peterdsharpe/phone-case/out/renders/camera_closeup.jpg

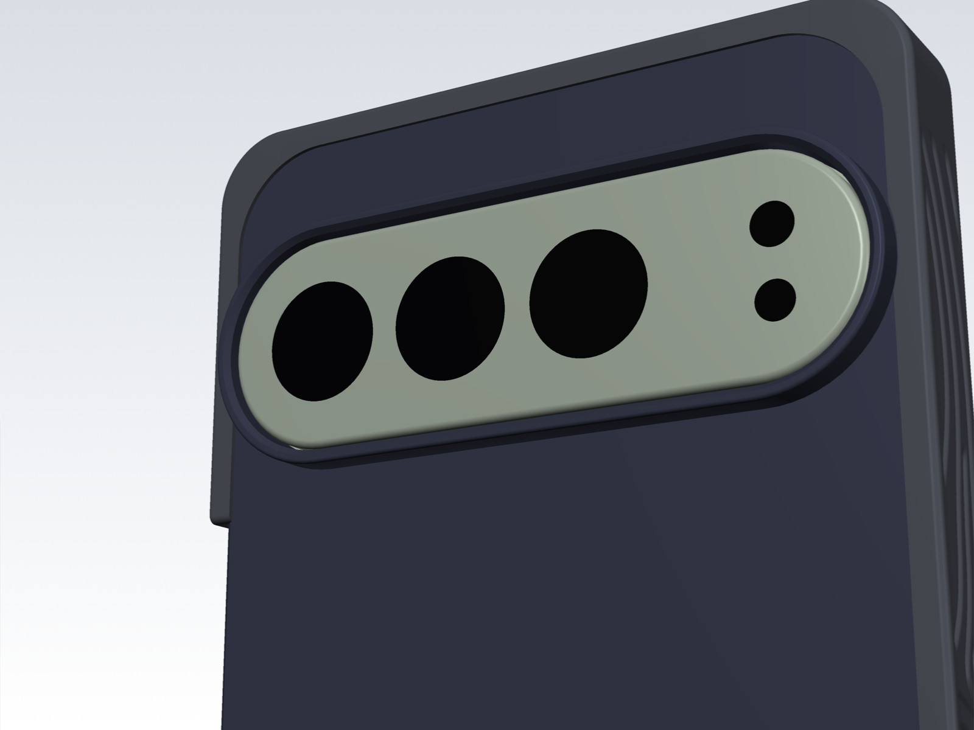
out/renders/camera_closeup.jpg
