peterdsharpe/phone-case/out/renders/corner_closeup.jpg

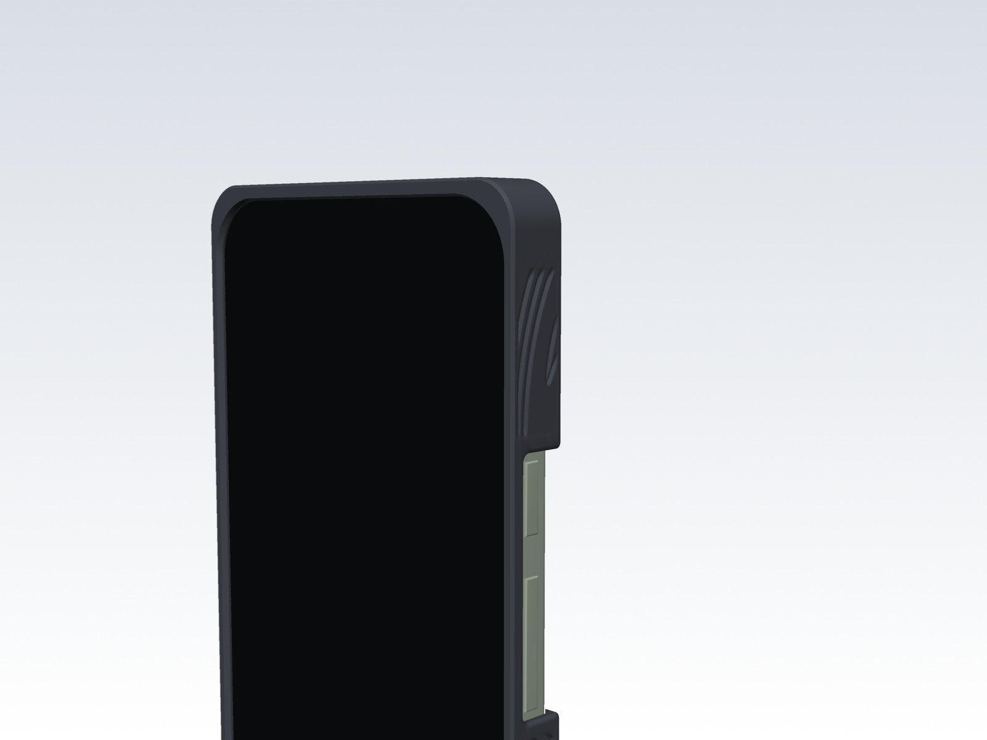
out/renders/corner_closeup.jpg
