peterdsharpe/phone-case/out/renders/exploded.jpg

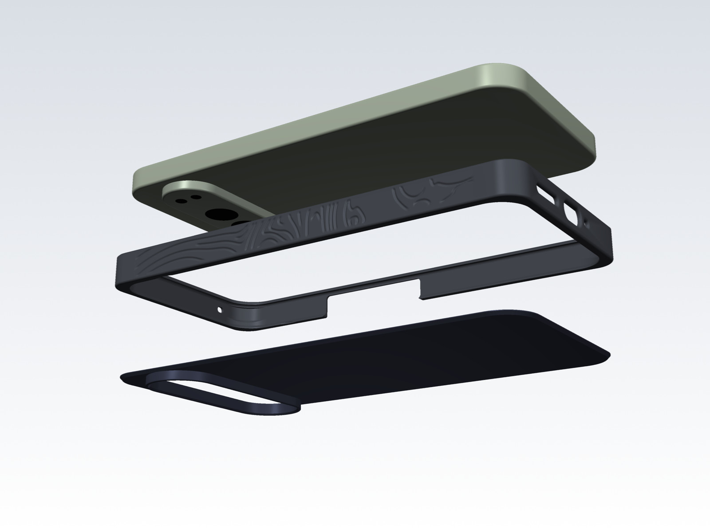
out/renders/exploded.jpg
