peterdsharpe/phone-case/out/renders/flow_spectra.png

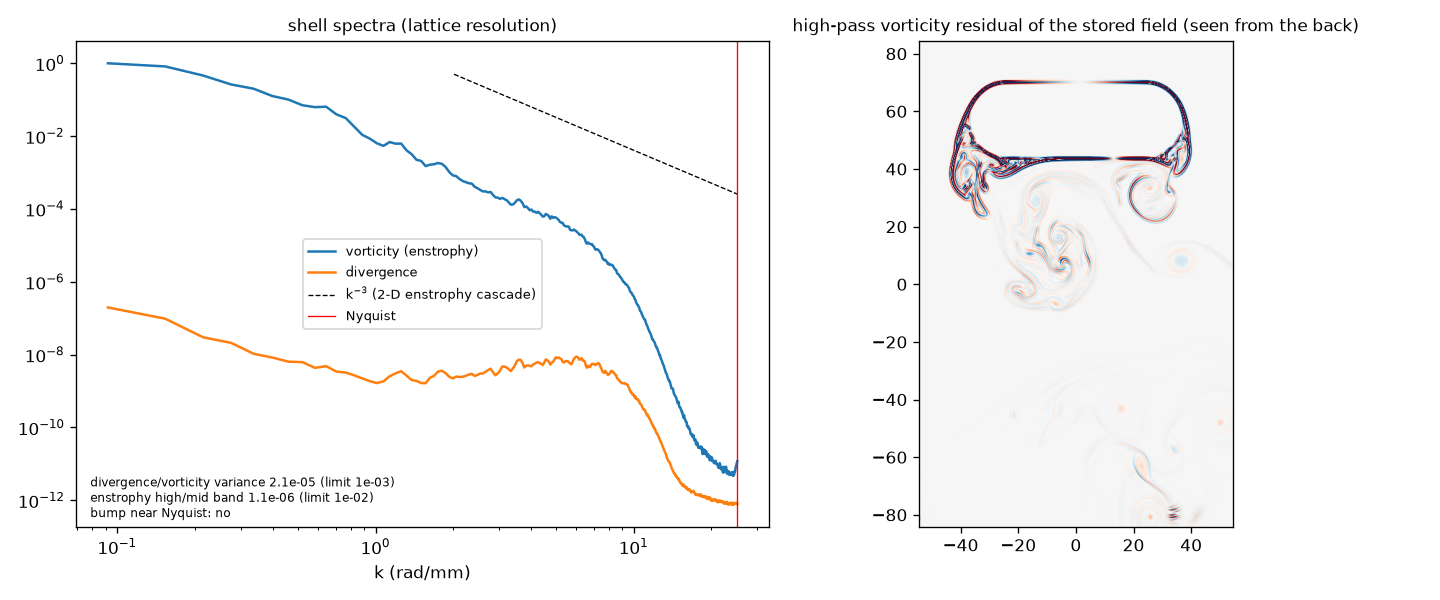
out/renders/flow_spectra.png
