peterdsharpe/phone-case/out/renders/sections.png

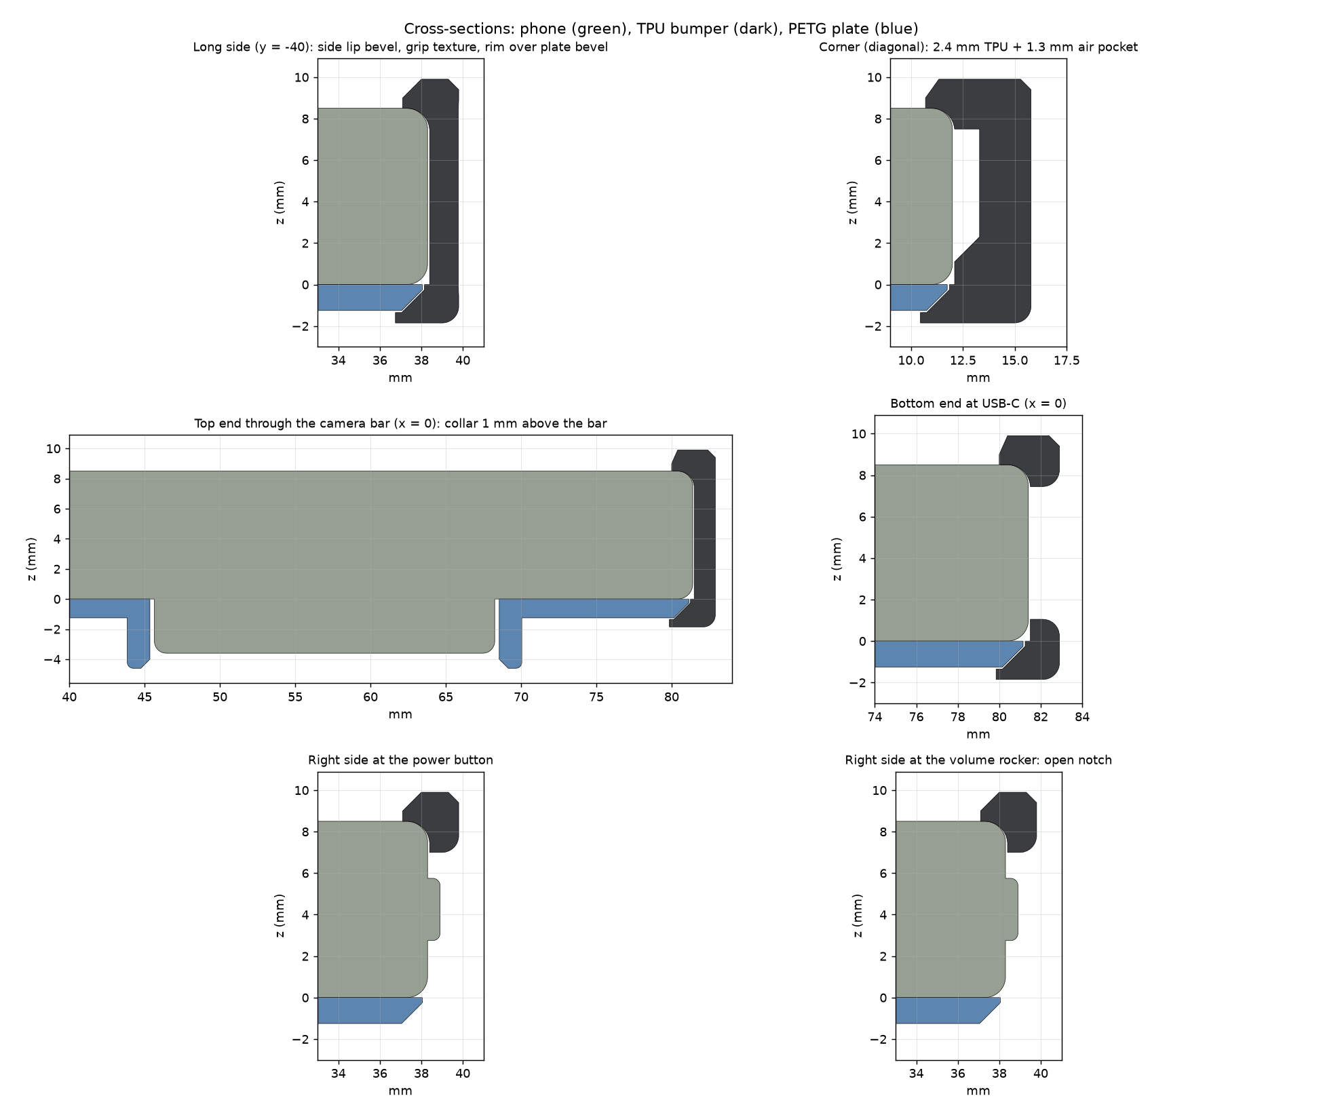
out/renders/sections.png
