peterdsharpe/phone-case/out/renders/stream_bead_detail.jpg

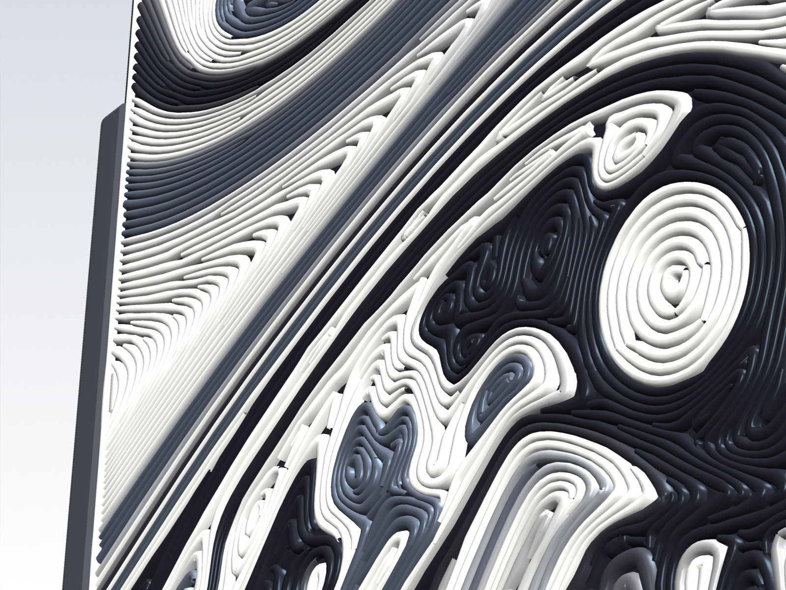
out/renders/stream_bead_detail.jpg
