peterdsharpe/phone-case/out/renders/stream_collar_closeup.jpg

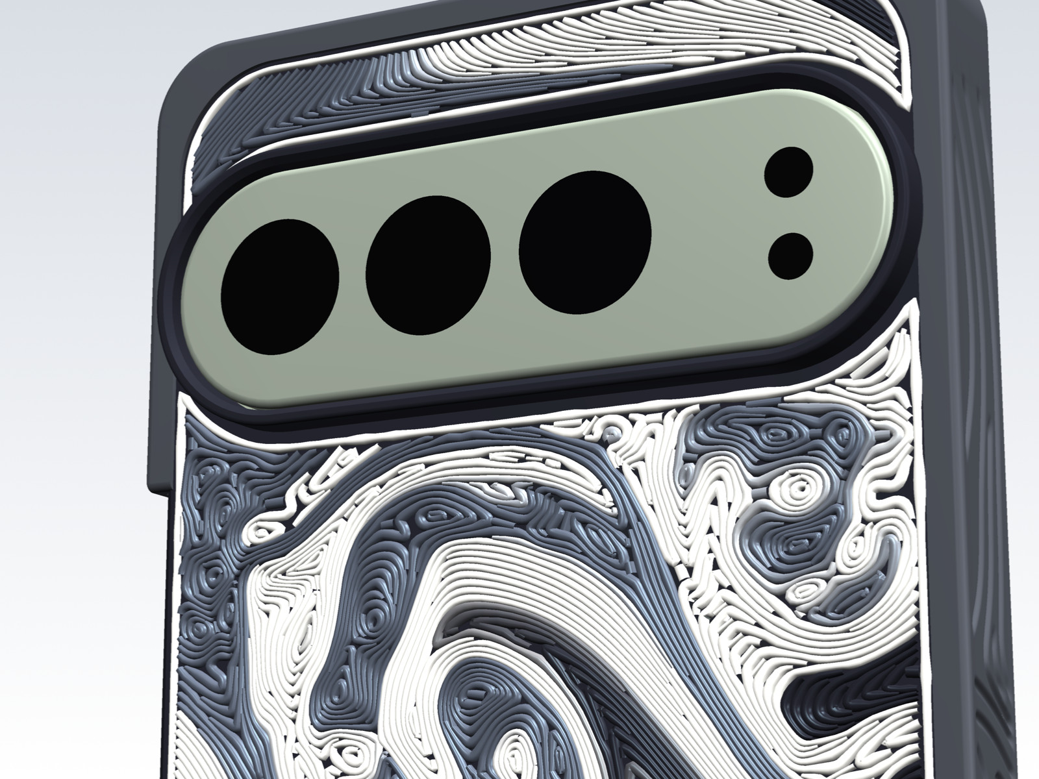
out/renders/stream_collar_closeup.jpg
