peterdsharpe/phone-case/out/renders/stream_plan_petg.jpg

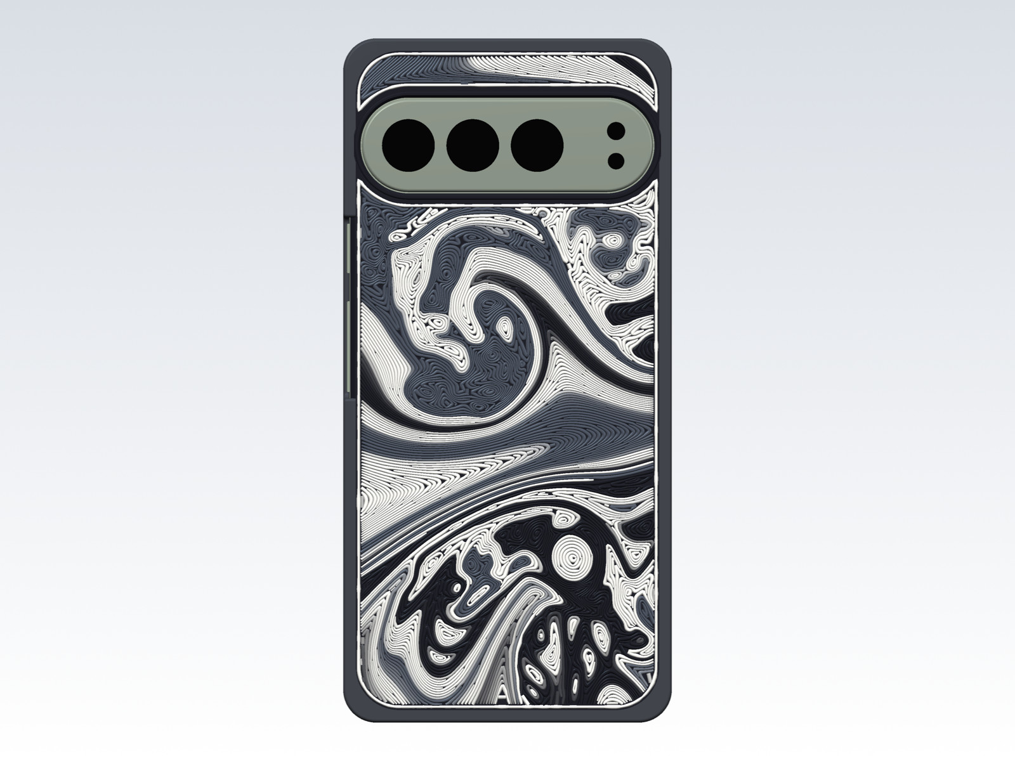
out/renders/stream_plan_petg.jpg
