peterdsharpe/phone-case/out/renders/streamline_flow.png

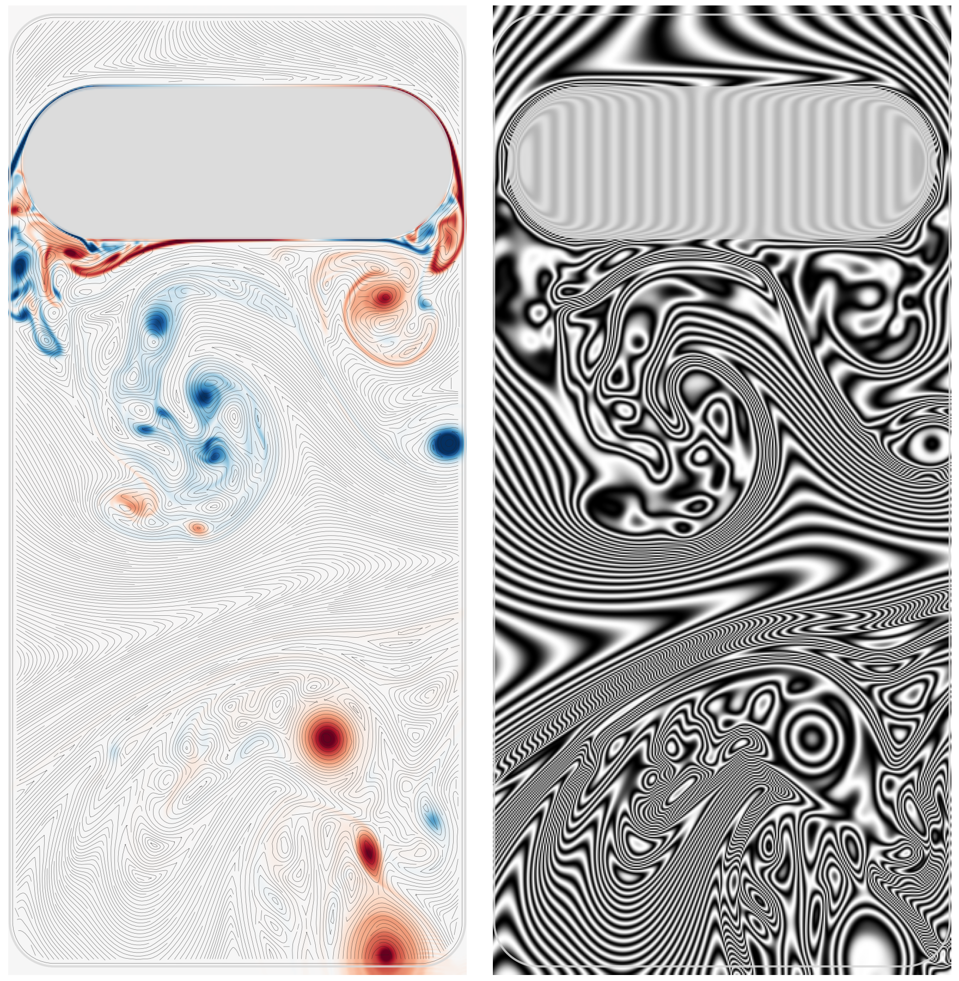
out/renders/streamline_flow.png
