peterdsharpe/phone-case/out/renders/streamline_toolpaths.png

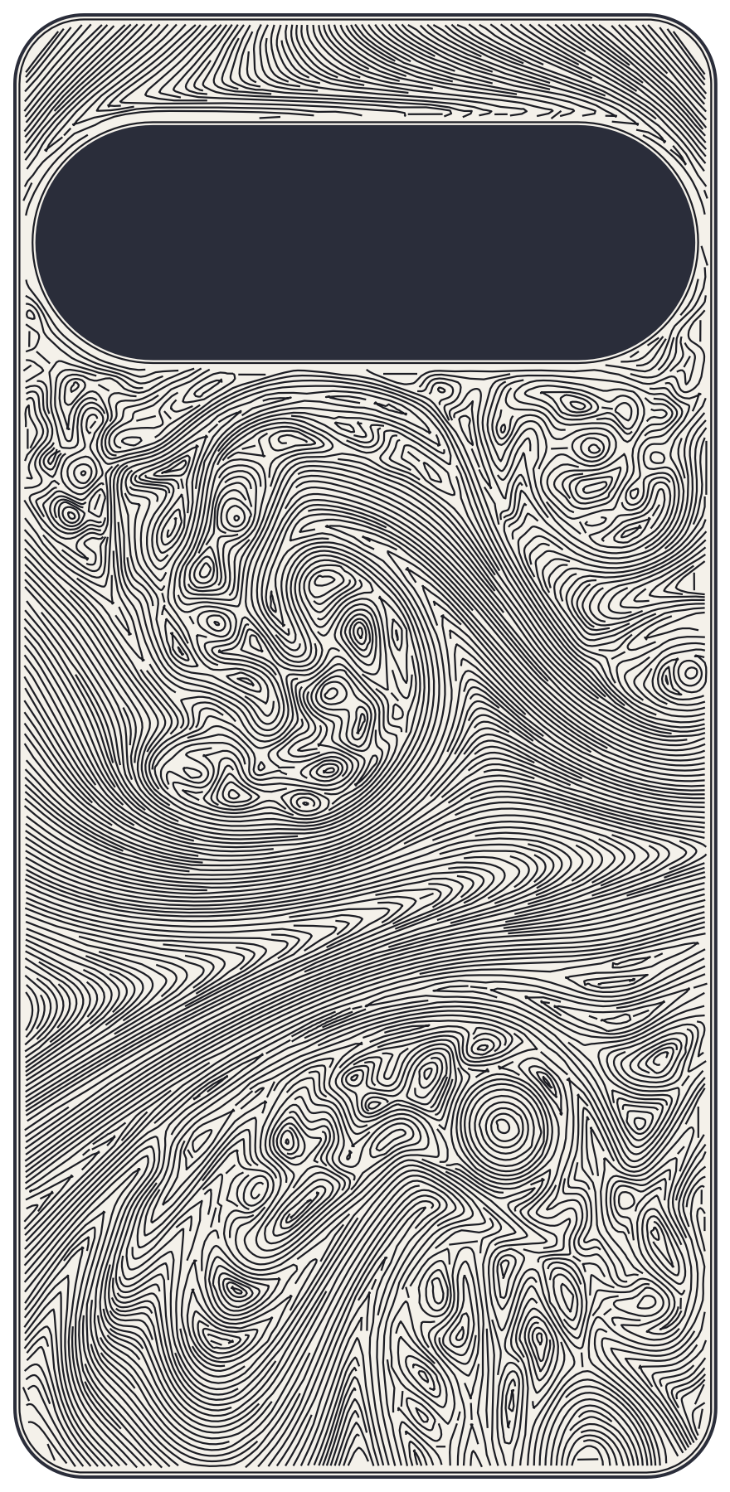
out/renders/streamline_toolpaths.png
