peterdsharpe/phone-case/out/print/case_back_petg.stl

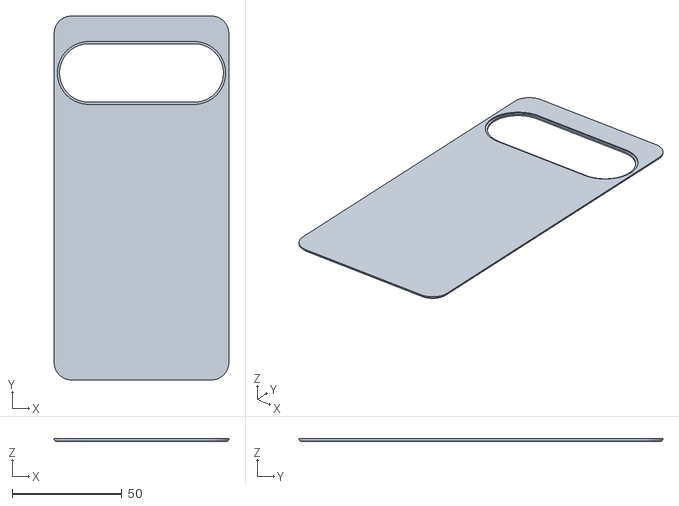
[picture p41: CAD file, 2026-10-22]
out/print/case_back_petg.stl
79.6 x 165.8 x 1.17
