peterdsharpe/phone-case/out/print/camera_ring.stl

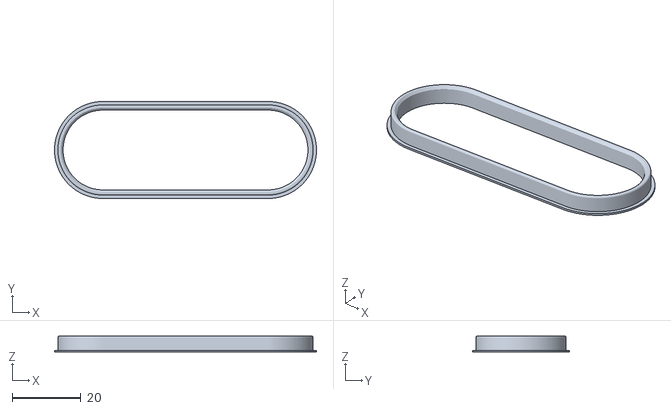
[picture p42: CAD file, 2026-10-22]
out/print/camera_ring.stl
76.2 x 28.2 x 4.60
