peterdsharpe/phone-case/out/print/case_fused.3mf

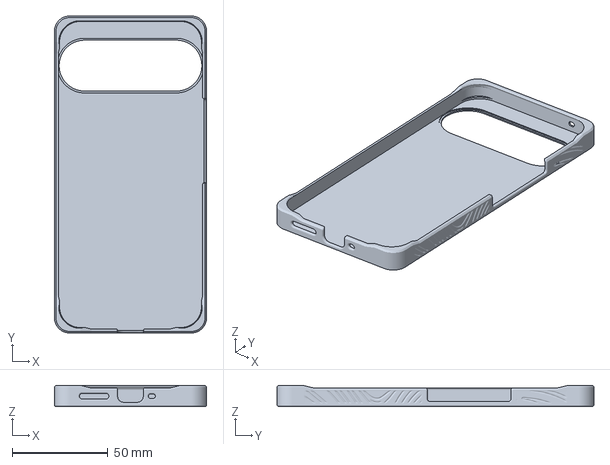
[picture p43: CAD file, 2026-10-22]
out/print/case_fused.3mf
79.6 x 165.8 x 11.1 mm
