peterdsharpe/phone-case/out/print/plate_pla.3mf

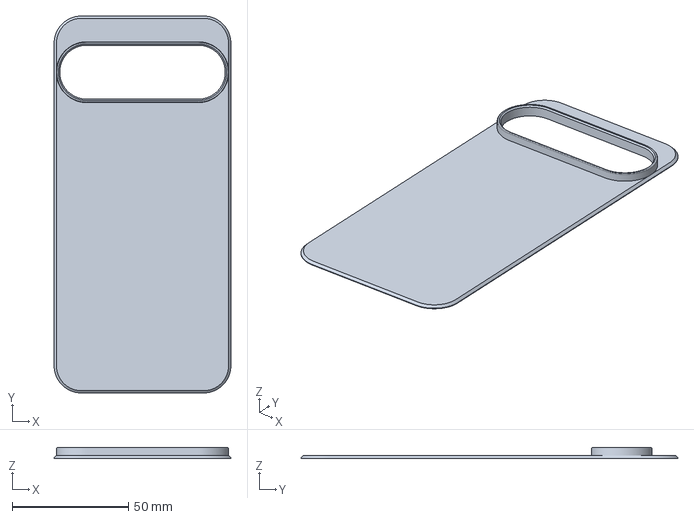
[picture p44: CAD file, 2026-10-22]
out/print/plate_pla.3mf
76.1 x 162.3 x 4.60 mm
