peterdsharpe/phone-case/out/print/test_camera_petg.3mf

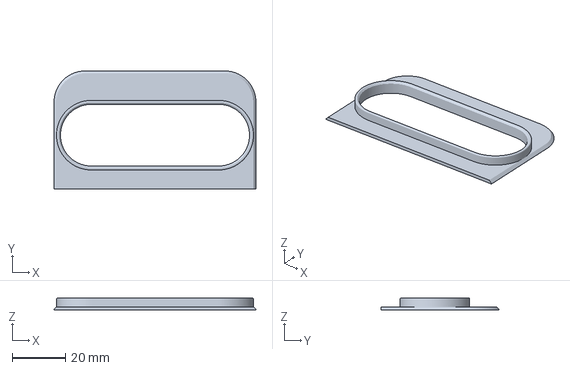
[picture p45: CAD file, 2026-10-22]
out/print/test_camera_petg.3mf
76.1 x 44.5 x 4.60 mm
