peterdsharpe/phone-case/out/print/test_fit_band_tpu.3mf

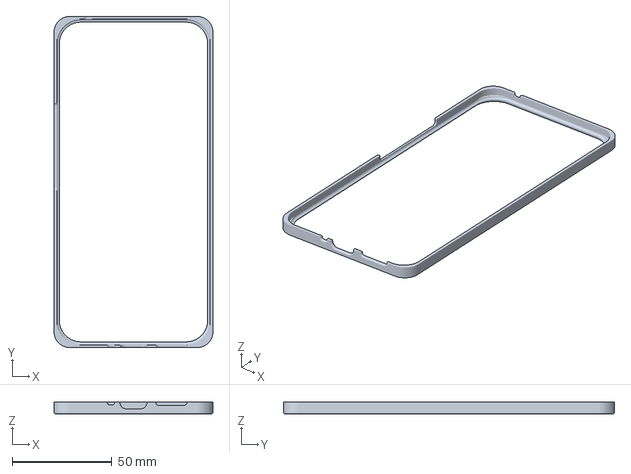
[picture p46: CAD file, 2026-10-22]
out/print/test_fit_band_tpu.3mf
79.6 x 165.8 x 5.90 mm
