peterdsharpe/phone-case/out/print/bumper_tpu.3mf

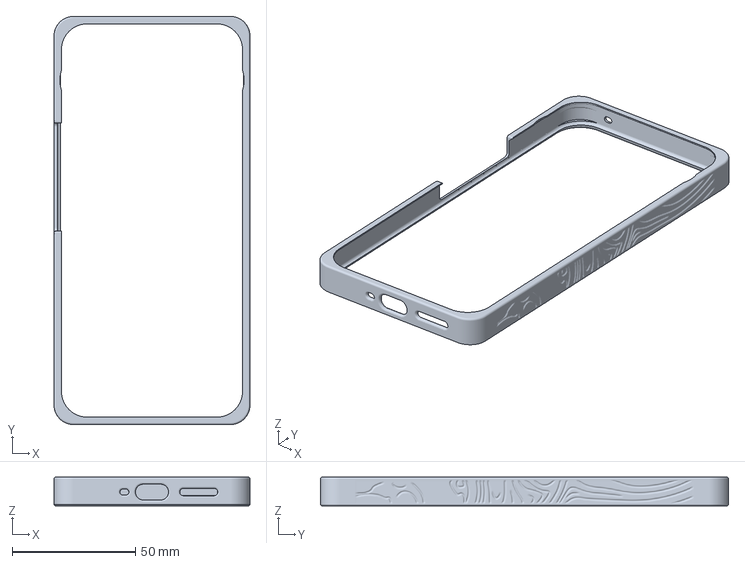
[picture p47: CAD file, 2026-10-22]
out/print/bumper_tpu.3mf
79.6 x 165.8 x 11.7 mm
