peterdsharpe/phone-case/out/print/bumper_petg.3mf

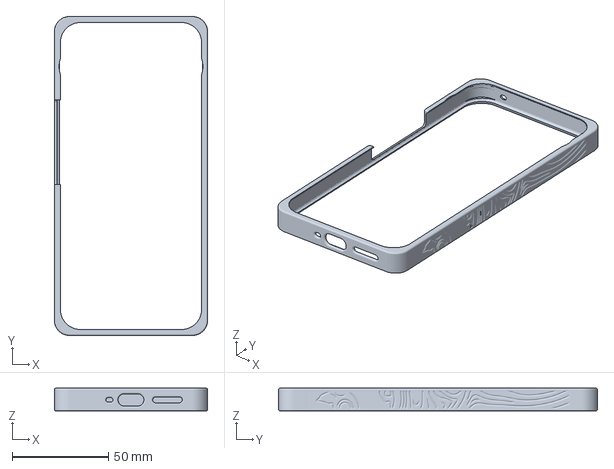
[picture p48: CAD file, 2026-10-22]
out/print/bumper_petg.3mf
79.8 x 166.0 x 11.7 mm
