peterdsharpe/phone-case/(list of files, cad)

Other CAD files:
out/print/camera_ring_petg.3mf
out/print/plate_petg.3mf
out/print/test_fit_band.stl
out/print/test_camera.stl
out/print/plate.stl
