peterdsharpe/phone-case/out/renders/print_layout.jpg

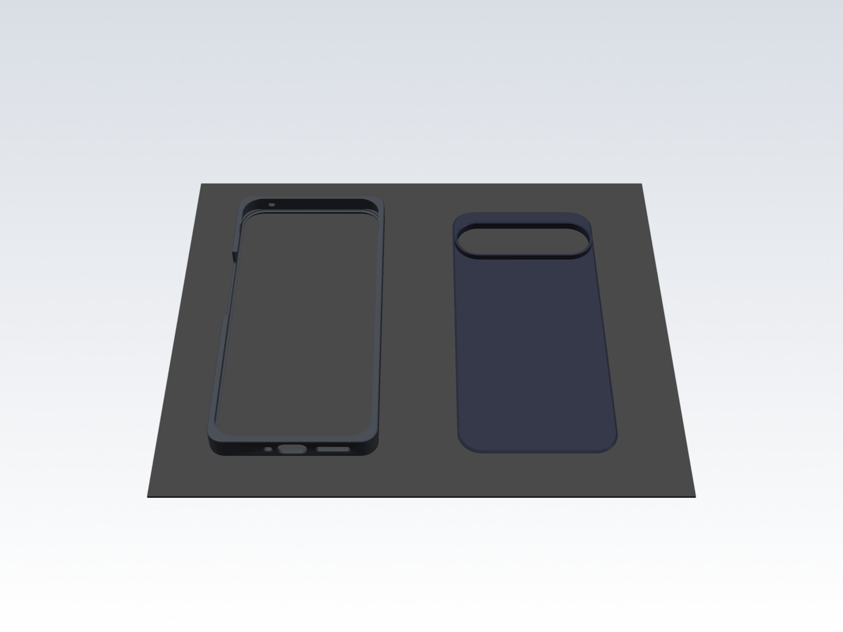
out/renders/print_layout.jpg
