peterdsharpe/phone-case/out/profiles/camera_ring_petg.ini

# PrusaSlicer config for camera_ring_petg: Original Prusa i3 MK3S & MK3S+ 0.6 nozzle + 0.15mm DETAIL @0.6 nozzle MK3 + Prusament PETG @0.6 nozzle + overrides.
# Import with File > Import > Import Config.
avoid_crossing_perimeters = 1
bed_shape = 0x0,250x0,250x210,0x210
bed_temperature = 90
before_layer_gcode = ;BEFORE_LAYER_CHANGE\nG92 E0.0\n;[layer_z]\n\n
between_objects_gcode = 
bottom_fill_pattern = concentric
bottom_solid_layers = 6
bottom_solid_min_thickness = 0.6
bridge_acceleration = 1000
bridge_angle = 0
bridge_fan_speed = 80
bridge_flow_ratio = 1
bridge_speed = 20
brim_separation = 0.1
brim_type = outer_only
brim_width = 5
color_change_gcode = M600\nG1 E0.4 F1500 ; prime after color change
complete_objects = 0
cooling = 1
default_acceleration = 1000
deretract_speed = 25
disable_fan_first_layers = 3
dont_support_bridges = 0
elefant_foot_compensation = 0.15
enable_dynamic_fan_speeds = 1
enable_dynamic_overhang_speeds = 1
end_filament_gcode = "; Filament-specific end gcode"
end_gcode = {if layer_z < max_print_height}G1 Z{z_offset+min(max_layer_z+1, max_print_height)} F720 ; Move print head up{endif}\nG1 X0 Y200 F3600 ; park\n{if layer_z < max_print_height}G1 Z{z_offset+min(max_layer_z+49, max_print_height)} F720 ; Move print head further up{endif}\nG4 ; wait\nM221 S100 ; reset flow\nM900 K0 ; reset LA\n{if print_settings_id=~/.*(DETAIL @MK3|QUALITY @MK3|@0.25 nozzle MK3).*/}M907 E538 ; reset extruder motor current{endif}\nM104 S0 ; turn off temperature\nM140 S0 ; turn off heatbed\nM107 ; turn off fan\nM84 ; disable motors\n; max_layer_z = [max_layer_z]
ensure_vertical_shell_thickness = 1
external_fill_pattern = rectilinear
external_perimeter_extrusion_width = 0.7
external_perimeter_speed = 25
external_perimeters_first = 0
extra_perimeters = 0
extruder_clearance_height = 20
extruder_clearance_radius = 45
extruder_offset = 0x0
extrusion_multiplier = 1
extrusion_width = 0.65
fan_always_on = 1
fan_below_layer_time = 20
filament_colour = #FF8000
filament_cooling_final_speed = 3.4
filament_cooling_initial_speed = 2.2
filament_cooling_moves = 4
filament_cost = 36.29
filament_density = 1.27
filament_diameter = 1.75
filament_load_time = 0
filament_loading_speed = 28
filament_loading_speed_start = 3
filament_max_volumetric_speed = 10
filament_minimal_purge_on_wipe_tower = 15
filament_notes = ""
filament_ramming_parameters = "120 100 6.6 6.8 7.2 7.6 7.9 8.2 8.7 9.4 9.9 10.0| 0.05 6.6 0.45 6.8 0.95 7.8 1.45 8.3 1.95 9.7 2.45 10 2.95 7.6 3.45 7.6 3.95 7.6 4.45 7.6 4.95 7.6"
filament_retract_length = 0.8
filament_retract_lift = 0.2
filament_settings_id = Prusament PETG (phone-case camera ring)
filament_soluble = 0
filament_spool_weight = 278
filament_toolchange_delay = 0
filament_type = PETG
filament_unload_time = 0
filament_unloading_speed = 90
filament_unloading_speed_start = 100
filament_vendor = Prusa Polymers
filament_wipe = 1
fill_angle = 45
fill_density = 100%
fill_pattern = rectilinear
first_layer_acceleration = 800
first_layer_bed_temperature = 85
first_layer_extrusion_width = 0.65
first_layer_height = 0.24
first_layer_speed = 15
first_layer_temperature = 240
full_fan_speed_layer = 5
gap_fill_speed = 40
gcode_comments = 0
gcode_flavor = marlin
gcode_label_objects = 1
infill_acceleration = 1000
infill_anchor = 2.5
infill_anchor_max = 15
infill_every_layers = 1
infill_extruder = 1
infill_extrusion_width = 0.65
infill_first = 0
infill_only_where_needed = 0
infill_overlap = 15%
infill_speed = 70
interface_shells = 0
ironing = 1
ironing_type = top
layer_gcode = ;AFTER_LAYER_CHANGE\n;[layer_z]
layer_height = 0.12
machine_limits_usage = emit_to_gcode
machine_max_acceleration_e = 5000,5000
machine_max_acceleration_extruding = 1250,1250
machine_max_acceleration_retracting = 1250,1250
machine_max_acceleration_x = 1000,960
machine_max_acceleration_y = 1000,960
machine_max_acceleration_z = 200,200
machine_max_feedrate_e = 120,120
machine_max_feedrate_x = 200,100
machine_max_feedrate_y = 200,100
machine_max_feedrate_z = 12,12
machine_max_jerk_e = 4.5,4.5
machine_max_jerk_x = 8,8
machine_max_jerk_y = 8,8
machine_max_jerk_z = 0.4,0.4
machine_min_extruding_rate = 0,0
machine_min_travel_rate = 0,0
max_fan_speed = 60
max_layer_height = 0.40
max_print_height = 210
max_print_speed = 100
max_volumetric_extrusion_rate_slope_negative = 0
max_volumetric_extrusion_rate_slope_positive = 0
max_volumetric_speed = 0
min_fan_speed = 30
min_layer_height = 0.07
min_print_speed = 15
min_skirt_length = 4
notes = 
nozzle_diameter = 0.6
octoprint_apikey = 
octoprint_host = 
only_retract_when_crossing_perimeters = 0
ooze_prevention = 0
output_filename_format = {input_filename_base}_0.6n_{layer_height}mm_{printing_filament_types}_{printer_model}_{print_time}.gcode
overhang_fan_speed_0 = 90
overhang_fan_speed_1 = 70
overhang_fan_speed_2 = 50
overhang_fan_speed_3 = 35
overhang_speed_0 = 12
overhang_speed_1 = 15
overhang_speed_2 = 20
overhang_speed_3 = 25
overhangs = 1
perimeter_acceleration = 800
perimeter_extruder = 1
perimeter_extrusion_width = 0.7
perimeter_generator = arachne
perimeter_speed = 35
perimeters = 2
post_process = 
print_settings_id = 0.15mm DETAIL @0.6 nozzle MK3
printer_model = MK3S
printer_notes = Don't remove the following keywords! These keywords are used in the "compatible printer" condition of the print and filament profiles to link the particular print and filament profiles to this printer profile.\nPRINTER_VENDOR_PRUSA3D\nPRINTER_MODEL_MK3\n
printer_settings_id = Original Prusa i3 MK3S & MK3S+ 0.6 nozzle
printer_technology = FFF
printer_variant = 0.6
raft_contact_distance = 0.2
raft_first_layer_density = 90%
raft_layers = 0
remaining_times = 1
resolution = 0
retract_before_travel = 1
retract_before_wipe = 0%
retract_layer_change = 1
retract_length = 0.8
retract_length_toolchange = 4
retract_lift = 0.4
retract_lift_above = 0
retract_lift_below = 209
retract_restart_extra = 0
retract_restart_extra_toolchange = 0
retract_speed = 35
scarf_seam_length = 15
scarf_seam_only_on_smooth = 1
scarf_seam_placement = everywhere
seam_gap = 10%
seam_position = rear
serial_port = 
serial_speed = 250000
silent_mode = 1
single_extruder_multi_material = 0
single_extruder_multi_material_priming = 0
skirt_distance = 3
skirt_height = 3
skirts = 0
slowdown_below_layer_time = 17
small_perimeter_speed = 20
solid_infill_below_area = 0
solid_infill_every_layers = 0
solid_infill_extruder = 1
solid_infill_extrusion_width = 0.65
solid_infill_speed = 70
spiral_vase = 0
staggered_inner_seams = 1
standby_temperature_delta = -5
start_filament_gcode = "{if printer_notes!~/.*(MK3.5|MINIIS).*/}\nM900 K{if printer_notes=~/.*PRINTER_MODEL_MINI.*/ and nozzle_diameter[0]==0.6}0.12{elsif printer_notes=~/.*PRINTER_MODEL_MINI.*/ and nozzle_diameter[0]==0.8}0.06{elsif printer_notes=~/.*PRINTER_MODEL_MINI.*/}0.2{elsif nozzle_diameter[0]==0.8}0.02{elsif nozzle_diameter[0]==0.6}0.04{else}0.08{endif} ; Filament gcode LA 1.5\n{if printer_notes=~/.*PRINTER_MODEL_MINI.*/};{elsif printer_notes=~/.*PRINTER_HAS_BOWDEN.*/}M900 K200{elsif nozzle_diameter[0]==0.6}M900 K24{elsif nozzle_diameter[0]==0.8};{else}M900 K45{endif} ; Filament gcode LA 1.0\n{endif}\n\n{if printer_notes=~/.*MINIIS.*/}\nM572 S{if nozzle_diameter[0]==0.6}0.22{elsif nozzle_diameter[0]==0.8}0.15{elsif nozzle_diameter[0]==0.4}0.36{elsif nozzle_diameter[0]==0.25}1.02{else}0{endif}\n{endif}\n\n{if printer_notes=~/.*MK3.5.*/}\nM572 S{if nozzle_diameter[0]==0.4}0.052{elsif nozzle_diameter[0]==0.5}0.042{elsif nozzle_diameter[0]==0.6}0.025{elsif nozzle_diameter[0]==0.8}0.018{elsif nozzle_diameter[0]==0.25}0.18{elsif nozzle_diameter[0]==0.3}0.1{else}0{endif} ; Filament gcode\n{endif}"
start_gcode = M862.3 P \"[printer_model]\" ; printer model check\nM862.1 P[nozzle_diameter] ; nozzle diameter check\nM115 U3.14.1 ; tell printer latest fw version\nG90 ; use absolute coordinates\nM83 ; extruder relative mode\nM104 S[first_layer_temperature] ; set extruder temp\nM140 S[first_layer_bed_temperature] ; set bed temp\nM190 S[first_layer_bed_temperature] ; wait for bed temp\nM109 S[first_layer_temperature] ; wait for extruder temp\nG28 W ; home all without mesh bed level\nG80 X{first_layer_print_min[0]} Y{first_layer_print_min[1]} W{(first_layer_print_max[0]) - (first_layer_print_min[0])} H{(first_layer_print_max[1]) - (first_layer_print_min[1])} ; mesh bed levelling\n{if filament_settings_id[initial_tool]=~/.*Prusament PA11.*/}\nG1 Z0.3 F720\nG1 Y-3 F1000 ; go outside print area\nG92 E0\nG1 X60 E9 F1000 ; intro line\nG1 X100 E9 F1000 ; intro line\n{else}\nG1 Z0.2 F720\nG1 Y-3 F1000 ; go outside print area\nG92 E0\nG1 X60 E9 F1000 ; intro line\nG1 X100 E12.5 F1000 ; intro line\n{endif}\nG92 E0\nM221 S{if layer_height<0.075}100{else}95{endif}
support_material = 1
support_material_angle = 0
support_material_auto = 0
support_material_bottom_interface_layers = 0
support_material_buildplate_only = 0
support_material_contact_distance = 0.22
support_material_enforce_layers = 0
support_material_extruder = 0
support_material_extrusion_width = 0.55
support_material_interface_contact_loops = 0
support_material_interface_extruder = 0
support_material_interface_layers = 2
support_material_interface_spacing = 0.3
support_material_interface_speed = 80%
support_material_pattern = rectilinear
support_material_spacing = 2
support_material_speed = 50
support_material_style = organic
support_material_synchronize_layers = 0
support_material_threshold = 50
support_material_with_sheath = 0
support_material_xy_spacing = 80%
support_tree_angle_slow = 30
support_tree_branch_diameter_angle = 3
support_tree_branch_diameter_double_wall = 8
support_tree_tip_diameter = 1.2
support_tree_top_rate = 30%
temperature = 240
thick_bridges = 0
thin_walls = 0
thumbnails = 160x120
toolchange_gcode = 
top_fill_pattern = concentric
top_infill_extrusion_width = 0.6
top_solid_infill_speed = 45
top_solid_layers = 6
top_solid_min_thickness = 0.9
travel_speed = 180
travel_speed_z = 12
use_firmware_retraction = 0
use_relative_e_distances = 1
use_volumetric_e = 0
variable_layer_height = 1
wipe = 1
wipe_tower = 1
wipe_tower_bridging = 10
wipe_tower_rotation_angle = 0
wipe_tower_width = 60
wipe_tower_x = 170
wipe_tower_y = 125
xy_size_compensation = 0
z_offset = 0
