peterdsharpe/phone-case/(commit log)

2026-10-15 Parametric Pixel 9 Pro XL case: TPU bumper + PETG topo back plate
    build123d model of a two-part case. The TPU bumper prints lip-down and has
    thick corners with air pockets, a gesture-friendly bevelled side lip, button
    and port openings, and a rear rim that captures the plate. The PETG back plate
    prints face-up with the camera collar and a terraced topographic relief (one
    0.15 mm layer per terrace).
    Phone dimensions come from Google's spec plus ten published Pixel 9 Pro XL
    cases (see case/params.py and MEASURE.md). The build exports STL/STEP, makes
    PrusaSlicer 2.9.6 projects from Prusa's MK3S+ 0.6 mm presets, slices them to
    check, and renders previews.
    [bumper.stl, bumper_tpu.3mf, plate.stl, plate_petg.3mf, plate_petg_2color.3mf, test_camera.stl, test_camera_petg.3mf, test_fit_band.stl]
2026-10-15 Solid plate infill, smaller collar fillet, earpiece check, prusa-slicer notes
    [bumper_tpu.3mf, plate.stl, plate_petg.3mf, plate_petg_2color.3mf, test_camera.stl, test_camera_petg.3mf, test_fit_band_tpu.3mf]
2026-10-15 Streamline back plate: toolpaths along the camera collar's wake
    The plate's visible face is now one extra 0.25 mm layer whose beads follow the
    streamlines of flow past the camera collar, spliced into PrusaSlicer's G-code.
    - case/lbm.py: numba D2Q9 lattice-Boltzmann (regularized BGK), the phone back
    as a window into open flow (periodic sides six collar-widths apart, outlet
    sponge), Re 1000 on the collar width. 16 velocity snapshots, cached in data/.
    - case/streamtrace.py: evenly spaced streamlines (Jobard & Lefer, numba core).
    - case/toolpath.py: lines ordered by stream function and printed in the flow
    direction, so hot-swapped colour pieces make stream tubes; closed loops get
    scatte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
    [bumper_tpu.3mf, plate.stl, plate_petg.3mf, plate_petg_2color.3mf, plate_pla.3mf, test_camera.stl, test_camera_petg.3mf, test_fit_band_tpu.3mf]
2026-10-15 Colour preview: beads at their own widths, without anti-aliasing seams
    [bumper_tpu.3mf, plate_petg.3mf, plate_pla.3mf, test_camera_petg.3mf, test_fit_band_tpu.3mf]
2026-10-16 Turbulent dye plate: dithered dye contours of a Re 30,000 GPU LBM wake
    Instantaneous streamlines of a 2-D flow look like electrostatic field lines.
    The toolpaths now follow dye instead: the LBM carries a label (the x where each
    parcel entered), whose contours are the streaklines of a rake at the inlet.
    - case/lbm_gpu.py: CUDA kernels (numba-cuda, float32), ~16 GLUPS on the local
    GPU; matches the CPU path to float32 rounding. Smagorinsky subgrid model,
    semi-Lagrangian bicubic dye advection. Default Re 30,000, 0.125 mm cells
    (594 across the collar), U = 0.025 so vortex cores stay near Mach 0.2.
    - case/contourpaths.py: level sets of the smoothed label at fine levels, each
    shown where t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
    [bumper_tpu.3mf, plate_petg.3mf, plate_pla.3mf, test_camera_petg.3mf, test_fit_band_tpu.3mf]
2026-10-16 Stabilise the LBM against grid-scale noise and gate builds on flow spectra
    The Re 30,000 wake grew striped wave packets about five lattice cells across in
    fast vortex edges (local lattice speed up to 0.11 at U = 0.025), which showed as
    hatching in the renders; phase 4, the default, was the worst snapshot. Fixes:
    lattice inflow speed 0.0125, Smagorinsky constant 0.17, and a separate bulk
    relaxation of the non-equilibrium stress trace (Dellar 2001). At Re 30,000, 15
    of 16 snapshots now pass; the plate uses phase 8.
    case/spectra.py computes vorticity and divergence shell spectra; lbm.run records
    them at lattice resolution for every snapshot, the build refuses a snapshot that
    fails and writes o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
    [bumper_tpu.3mf, plate_petg.3mf, plate_pla.3mf, test_camera_petg.3mf, test_fit_band_tpu.3mf]
2026-10-17 Prepare for public release: showcase README, portable PrusaSlicer discovery, JPEG renders
    - README rewritten as a picture-led showcase of the result and of how it was made:
    the topographic and Kármán attempts, field-line streamlines, dye, dithered
    toolpaths, the grid-scale instability and its spectral fix, and the G-code splice.
    - docs/img/process: curated images of the design process.
    - New figure out/renders/streamline_pipeline.png: flow, dye, toolpaths, colour.
    - 3D renders saved as JPEG (a fifth of the size); the wake close-up uses the PETG palette.
    - slicer: PRUSASLICER and PRUSASLICER_PROFILES overrides; finds Prusa's vendor profiles in
    Flatpak (user or system), distro, macOS a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
2026-10-17 README: tighten two claims (coverage, bead widths)
2026-10-20 Bumper v2: open button notch, billow grip texture, PETG variant, tuned print profiles
    From the first prints (TPU and PETG bumpers):
    - One notch over power and volume, open at the back: printed lip-down, the closed
    windows' back edges were long bridges that sagged. Also removes the volume post.
    - Corner air pockets end in 45-degree roofs instead of flat hidden ceilings.
    - Grip: Kelvin-Helmholtz billows (dye lines rolled up by a Stuart vortex row), cut
    0.35 mm deep into the print mesh with manifold booleans (case/texture.py), now
    also above the buttons. The STEP files keep plain sides.
    - PETG bumper variant with 0.20 mm side clearance (Case.fit_rigid); TPU stays 0.10.
    - Tuned bumper prof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
    [bumper.stl, bumper_petg.3mf, bumper_tpu.3mf, plate_petg.3mf, plate_pla.3mf, test_camera_petg.3mf, test_fit_band.stl, test_fit_band_tpu.3mf]
2026-10-21 Grip from the back's own flow; rounded edges on every opening
    - Grip texture: the LBM domain is five collar-widths wide, so the flow past the phone's
    long edges comes from the same solve as the back. The stored window now reaches 16 mm
    past each edge (same deterministic GPU run: identical inside the phone outline; phase 8
    passes the spectral check over the wider window). Each side wall shows the strip of flow
    it would cover if the back were unrolled over the rim: grooves along the dye streaklines,
    dithered to about 2.5 mm apart by contour_paths, with a cosine profile that meets the wall
    tangentially and ends that fade out. Replaces the Stuart-vortex billows, which were a
    closed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
    [bumper_petg.3mf, bumper_tpu.3mf, plate_petg.3mf, plate_pla.3mf, test_camera_petg.3mf, test_fit_band.stl, test_fit_band_tpu.3mf]
2026-10-21 Keep printer_model in the flattened slicer configs
    DROP_KEYS removed printer_model and printer_variant along with the vendor bookkeeping keys,
    so every G-code started with M862.3 P "" (printer model check with an empty name): a
    warning on an MK3S+ set to Warn, a refusal on Strict. They are real settings that
    PrusaSlicer writes into the start G-code; keep them. Toolpaths unchanged.
    [bumper_petg.3mf, bumper_tpu.3mf, plate_petg.3mf, plate_pla.3mf, test_camera_petg.3mf, test_fit_band_tpu.3mf]
2026-10-22 Streamline layer 0.45 mm tall, capped at 5 mm^3/s
    Peter found the 0.25 mm layer hard to hand-feed: the pieces were short (the smallest 10 mm)
    and went by fast. At 0.45 mm (75% of the 0.6 mm nozzle; Prusa's profiles stop at 0.40, so
    the layer slot lifts max_layer_height for the plate) every piece is 1.8x longer, and with
    each line slowed to stay under 5 mm^3/s (toolpath.line_feed, Case.stream_flow) the feed pace
    stays about 1 mm/s, so each piece lasts about 1.7x longer. Same line pattern (spacing 0.55);
    the colours are more opaque over the black base, the beads read as texture, and the hotend's
    colour blend covers about half as much plate. The rim stands 0.15 mm above the beads.
    Layer: 780 l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
    [bumper_petg.3mf, bumper_tpu.3mf, plate_petg.3mf, plate_pla.3mf, test_camera_petg.3mf, test_fit_band_tpu.3mf]
2026-10-22 Version 3: one-print case (PETG back + TPU walls) and a camera ring
    The back and the walls now print in one job on the MK3S+. The first layer is
    the hand-fed streamline layer (0.45 mm, inside a 5 mm black brim), then six
    black PETG layers, then a manual M600 swap to TPU for the walls. The camera
    collar is a separate PETG ring with a flange that sits in a recess in the back.
    - case/shell.py: the fused geometry. Long sides and bottom flush with the
    screen (45-degree lean-in over the phone's edge), lips kept on the top edge
    and all four corners with 6 mm ramps, button notch and USB-C open to the
    front, 0.8 mm top and 0.6 mm base chamfers, opening and recess for the ring.
    - case/fused.py: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
    [camera_ring.stl, camera_ring_petg.3mf, case_back_petg.stl, case_fused.3mf]
